Marsfan/Bus-Loop-Display/Board-electronics/LED Board/LED Board.kicad_pcb

## KiCad design Board-electronics/LED Board/LED Board.kicad_pcb (2017-06-11)

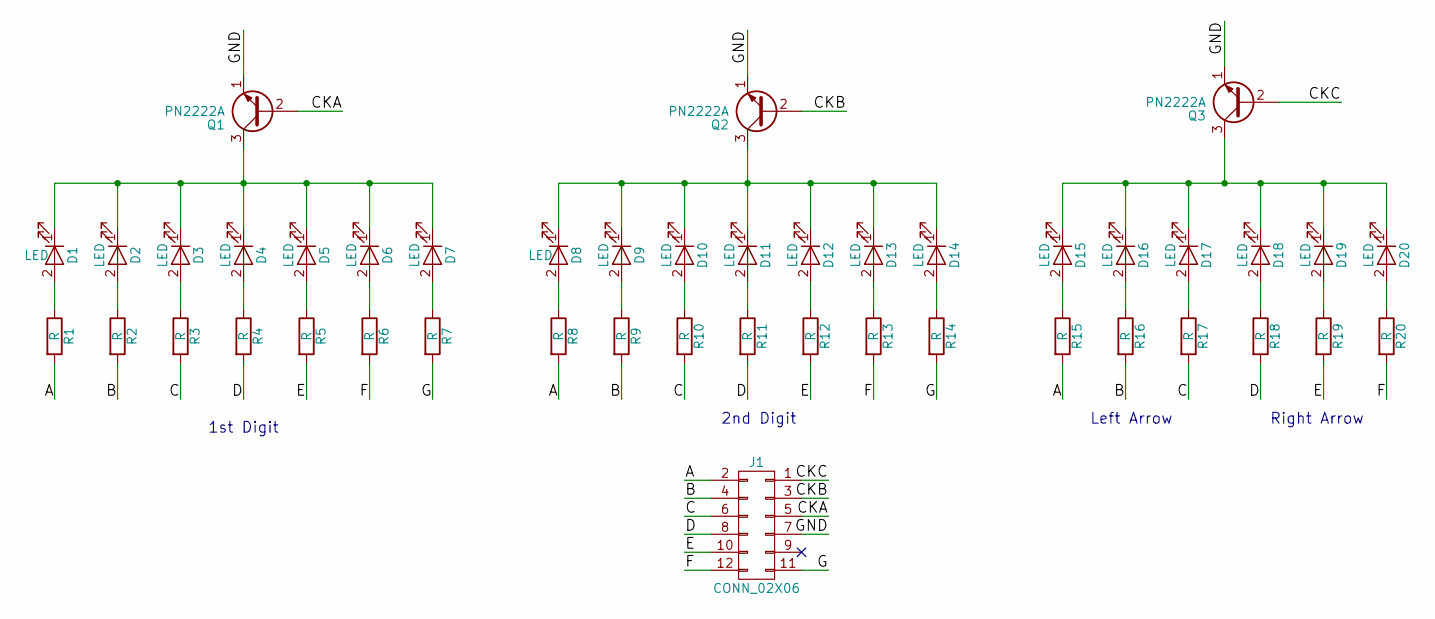
[picture p2: schematic LED Board.sch, LED Display Board]

Parts:
D1, D2, D3, D4, D5, D6, D7, D8, D9, D10, D11, D12, D13, D14, D15, D16, D17, D18, D19, D20: LED; LED_D5.0mm
J1: CONN_02X06; Picofit-12
Q1, Q2, Q3: PN2222A; TO-92_Molded_Wide_Oval
R1, R2, R3, R4, R5, R6, R7, R8, R9, R10, R11, R12, R13, R14, R15, R16, R17, R18, R19, R20: R; R_Axial_DIN0207_L6.3mm_D2.5mm_P10.16mm_Horizontal

Connections:
/A: J1.2, R1.2, R8.2, R15.2
/B: J1.4, R2.2, R9.2, R16.2
/C: J1.6, R3.2, R10.2, R17.2
/CKA: J1.5, Q1.2 (B)
/CKB: J1.3, Q2.2 (B)
/CKC: J1.1, Q3.2 (B)
/D: J1.8, R4.2, R11.2, R18.2
/E: J1.10, R5.2, R12.2, R19.2
/F: J1.12, R6.2, R13.2, R20.2
/G: J1.11, R7.2, R14.2
/GND: J1.7, Q1.1 (E), Q2.1 (E), Q3.1 (E)
unnamed: D1.1 (K), D2.1 (K), D3.1 (K), D4.1 (K), D5.1 (K), D6.1 (K), D7.1 (K), Q1.3 (C)
unnamed: D1.2 (A), R1.1
unnamed: D2.2 (A), R2.1
unnamed: D3.2 (A), R3.1
unnamed: D4.2 (A), R4.1
unnamed: D5.2 (A), R5.1
unnamed: D6.2 (A), R6.1
unnamed: D7.2 (A), R7.1
unnamed: D8.2 (A), R8.1
unnamed: D9.2 (A), R9.1
unnamed: D8.1 (K), D9.1 (K), D10.1 (K), D11.1 (K), D12.1 (K), D13.1 (K), D14.1 (K), Q2.3 (C)
unnamed: D10.2 (A), R10.1
unnamed: D11.2 (A), R11.1
unnamed: D12.2 (A), R12.1
unnamed: D13.2 (A), R13.1
unnamed: D14.2 (A), R14.1
unnamed: D15.1 (K), D16.1 (K), D17.1 (K), D18.1 (K), D19.1 (K), D20.1 (K), Q3.3 (C)
unnamed: D15.2 (A), R15.1
unnamed: D16.2 (A), R16.1
unnamed: D17.2 (A), R17.1
unnamed: D18.2 (A), R18.1
unnamed: D19.2 (A), R19.1
unnamed: D20.2 (A), R20.1

Notes on the sheet:
1st Digit
2nd Digit
Left Arrow
Right Arrow

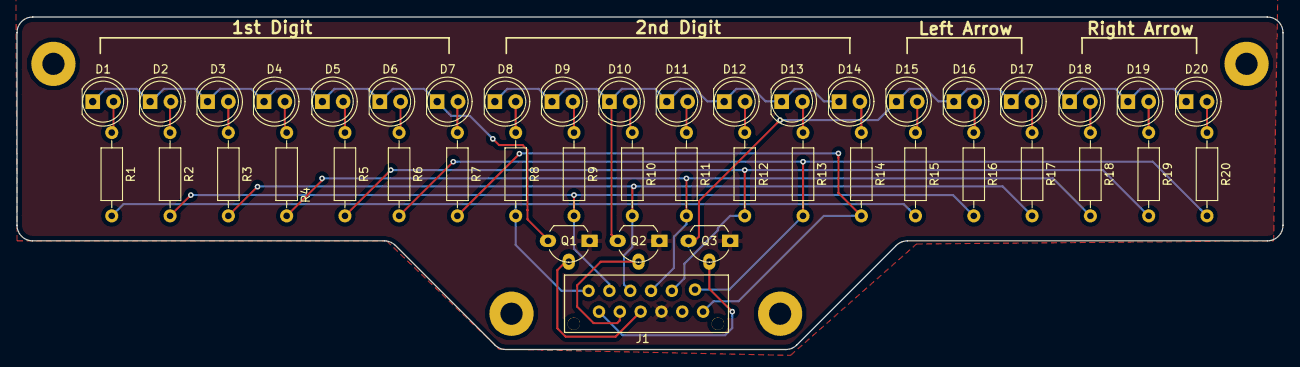
[picture p3: board LED Board.kicad_pcb from above]

Board: 2 copper layers, 154.4 x 40.6 mm, 44 parts (0 on the bottom side), 34 nets.
