Marsfan/Bus-Loop-Display/Board-electronics/Control Board no expansion header/Board Electronics.kicad_pcb

## KiCad design Board-electronics/Control Board no expansion header/Board Electronics.kicad_pcb (2017-05-10)

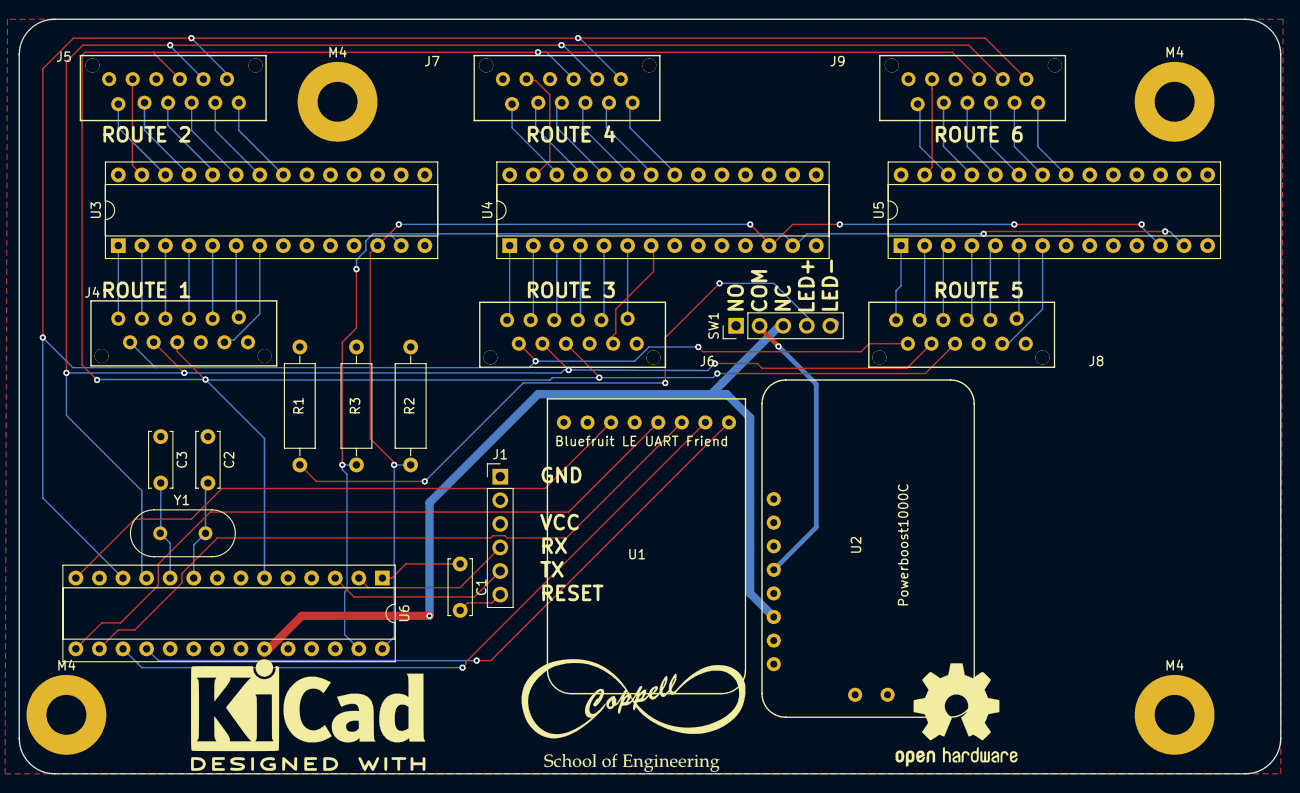
[picture p4: board Board-electronics/Control Board no expansion header/Board Electronics… from above]

Board: 2 copper layers, 135.9 x 81.3 mm, 25 parts (0 on the bottom side), 63 nets.

Parts:
C1: C.1uF; C_Disc_D6.0mm_W2.5mm_P5.00mm
C2, C3: C20p; C_Disc_D6.0mm_W2.5mm_P5.00mm
J1: CONN_01X06; Pin_Header_Straight_1x06_Pitch2.54mm
J4, J5, J6, J7, J8, J9: CONN_02X06; Picofit-12
M4, M4#2, M4#3, M4#4: MountingHole_4.3mm_M4_Pad
R1: R220; R_Axial_DIN0309_L9.0mm_D3.2mm_P12.70mm_Horizontal
R2, R3: R4K7; R_Axial_DIN0309_L9.0mm_D3.2mm_P12.70mm_Horizontal
SW1: SW_SPDT_LED; Pin_Header_Straight_1x05_Pitch2.54mm
U1: Adafruit_Bluefruit_LE_UART_Friend; Blueferuit_LE_UART
U2: Powerboost1000C; Powerboost1000c
U3, U4, U5: MCP23017; DIP-28_W7.62mm_Socket
U6: ATMEGA328P-PU; DIP-28_W7.62mm_Socket
Y1: Crystal; Crystal_HC49-U_Vertical

Connections:
/CKA: J4.5, J5.5, J6.5, J7.5, J8.5, J9.5, U6.6
/CKB: J4.3, J5.3, J6.3, J7.3, J8.3, J9.3, U6.11
/CKC: J4.1, J5.1, J6.1, J7.1, J8.1, J9.1, U6.12
/CTS: U1.2, U6.17
/GND: C2.1, C3.1, J1.1, J4.7, J5.7, J6.7, J7.7, J8.7, J9.7, SW1.1, SW1.5, U1.7, U2.7, U3.10, U3.15, U3.16, U3.17, U4.10, U4.16, U4.17, U5.10, U5.16, U5.17, U6.8, U6.22
/MOD: U1.1, U6.18
/RST: C1.2, J1.6
/RTS: U1.6, U6.14
/RX: J1.4, U6.2
/RXI: U1.4, U6.15
/SCL: R2.1, U3.12, U4.12, U5.12, U6.28
/SDA: R3.1, U3.13, U4.13, U5.13, U6.27
/TX: J1.5, U6.3
/TXO: U1.3, U6.16
/VCC: J1.3, R1.2, R2.2, R3.2, U1.5, U2.8, U3.9, U3.18, U4.9, U4.15, U4.18, U5.9, U5.15, U5.18, U6.7, U6.20
/controller.sch/A0: SW1.3, U2.6, U6.23
/controller.sch/RESET: C1.1, U6.1
unnamed: C2.2, U6.9, Y1.1
unnamed: C3.2, U6.10, Y1.2
unnamed: J4.2, U3.1
unnamed: J4.4, U3.2
unnamed: J4.6, U3.3
unnamed: J4.8, U3.4
unnamed: J4.9, U3.7
unnamed: J4.10, U3.5
unnamed: J4.12, U3.6
unnamed: J5.2, U3.21
unnamed: J5.4, U3.22
unnamed: J5.6, U3.23
unnamed: J5.8, U3.24
unnamed: J5.9, U3.27
unnamed: J5.10, U3.25
unnamed: J5.12, U3.26
unnamed: J6.2, U4.1
unnamed: J6.4, U4.2
unnamed: J6.6, U4.3
unnamed: J6.8, U4.4
unnamed: J6.9, U4.7
unnamed: J6.10, U4.5
unnamed: J6.12, U4.6
unnamed: J7.2, U4.21
unnamed: J7.4, U4.22
unnamed: J7.6, U4.23
unnamed: J7.8, U4.24
unnamed: J7.9, U4.27
unnamed: J7.10, U4.25
unnamed: J7.12, U4.26
unnamed: J8.2, U5.1
unnamed: J8.4, U5.2
unnamed: J8.6, U5.3
unnamed: J8.8, U5.4
unnamed: J8.9, U5.7
unnamed: J8.10, U5.5
unnamed: J8.12, U5.6
unnamed: J9.2, U5.21
unnamed: J9.4, U5.22
unnamed: J9.6, U5.23
unnamed: J9.8, U5.24
unnamed: J9.9, U5.27
unnamed: J9.10, U5.25
unnamed: J9.12, U5.26
unnamed: R1.1, SW1.4
unnamed: SW1.2, U2.4
