Marsfan/Bus-Loop-Display/Board-electronics/Control Board/Board Electronics.kicad_pcb

## KiCad design Board-electronics/Control Board/Board Electronics.kicad_pcb (2018-11-01)

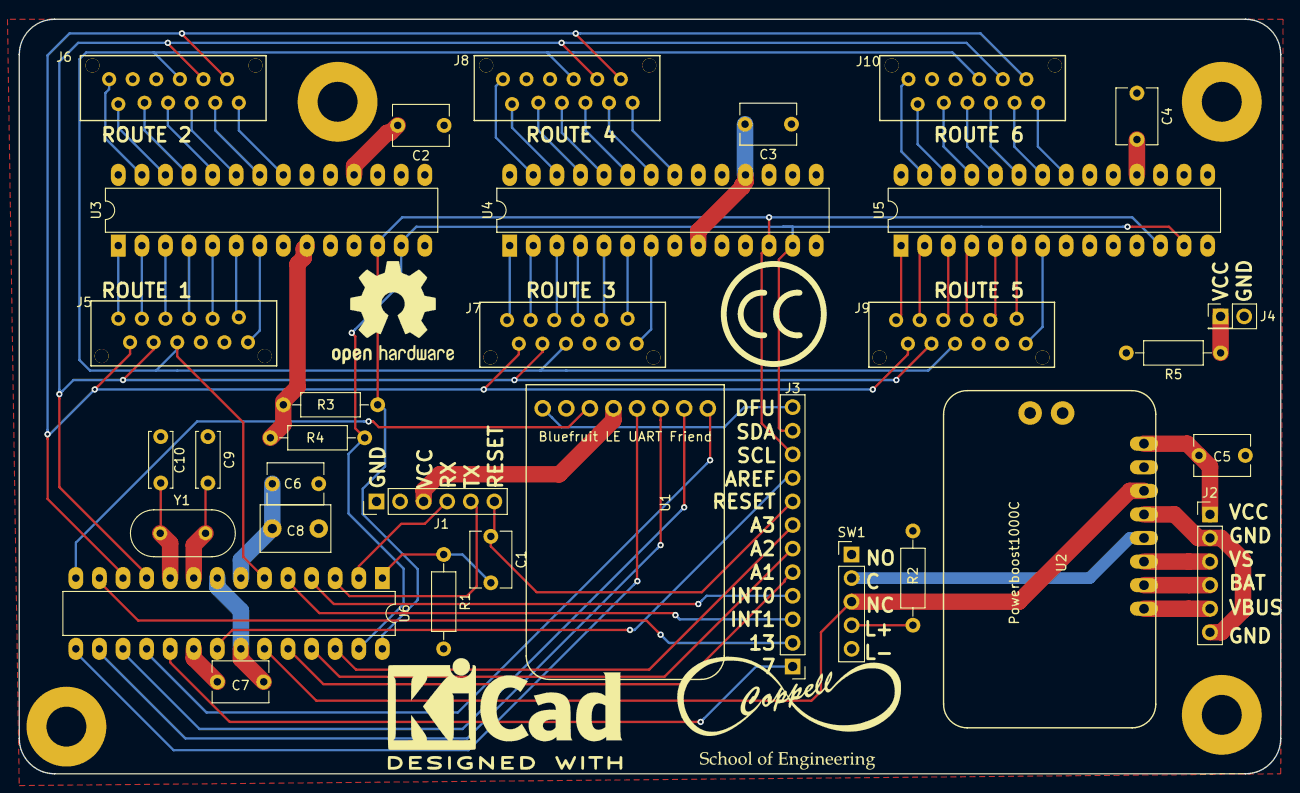
[picture p5: board Board-electronics/Control Board/Board Electronics.kicad_pcb from above]

Board: 2 copper layers, 135.9 x 81.3 mm, 37 parts (0 on the bottom side), 77 nets.

Parts:
C1: C.1uF; C_Disc_D6.0mm_W4.4mm_P5.00mm
C2, C3, C4, C6, C7: C.1u; C_Disc_D6.0mm_W4.4mm_P5.00mm
C5: C10u; C_Disc_D6.0mm_W4.4mm_P5.00mm
C8: C4.7u; C_Disc_D7.5mm_W5.0mm_P5.00mm
C9, C10: C20p; C_Disc_D6.0mm_W2.5mm_P5.00mm
J1, J2: CONN_01X06; Pin_Header_Straight_1x06_Pitch2.54mm
J3: CONN_01X12; Pin_Header_Straight_1x12_Pitch2.54mm
J4: CONN_02X01; Pin_Header_Straight_2x01_Pitch2.54mm
J5, J6, J7, J8, J9, J10: CONN_02X06; Picofit-12
M4, M4#2, M4#3, M4#4: MountingHole_4.3mm_M4_Pad
R1: R4.7K; R_Axial_DIN0207_L6.3mm_D2.5mm_P10.16mm_Horizontal
R2: R220; R_Axial_DIN0207_L6.3mm_D2.5mm_P10.16mm_Horizontal
R3, R4: R4K7; R_Axial_DIN0207_L6.3mm_D2.5mm_P10.16mm_Horizontal
R5: R; R_Axial_DIN0207_L6.3mm_D2.5mm_P10.16mm_Horizontal
SW1: SW_SPDT_LED; Pin_Header_Straight_1x05_Pitch2.54mm
U1: Adafruit_Bluefruit_LE_UART_Friend; Blueferuit_LE_UART
U2: Powerboost1000C; Powerboost1000c
U3, U4, U5: MCP23017; DIP-28_W7.62mm_LongPads
U6: ATMEGA328P-PU; DIP-28_W7.62mm_LongPads
Y1: Crystal; Crystal_HC49-U_Vertical

Connections:
/7: J3.2, U6.13
/13: J3.1, U6.19
/A0: SW1.3, U2.6, U6.23
/A1: J3.5, U6.24
/A2: J3.6, U6.25
/A3: J3.7, U6.26
/AREF: J3.9, U6.21
/BAT: J2.4, U2.2
/BLE_DFU: J3.12, U1.8
/CKA: J5.5, J6.5, J7.5, J8.5, J9.5, J10.5, U6.6
/CKB: J5.3, J6.3, J7.3, J8.3, J9.3, J10.3, U6.11
/CKC: J5.1, J6.1, J7.1, J8.1, J9.1, J10.1, U6.12
/CTS: U1.2, U6.17
/G: J2.2, J2.6, U2.5
/GND: C2.1, C3.1, C4.1, C5.2, C6.1, C7.2, C8.1, C9.1, C10.1, J1.1, J4.2, J5.7, J6.7, J7.7, J8.7, J9.7, J10.7, SW1.1, SW1.5, U1.7, U2.7, U3.10, U3.15, U3.16, U3.17, U4.10, U4.16, U4.17, U5.10, U5.17, U6.8, U6.22
/INT0: J3.4, U6.4
/INT1: J3.3, U6.5
/MOD: U1.1, U6.18
/RST: C1.1, J1.6, J3.8
/RTS: U1.6, U6.14
/RX: J1.4, U6.2
/RXI: U1.4, U6.15
/SCL: J3.10, R3.1, U3.12, U4.12, U5.12, U6.28
/SDA: J3.11, R4.1, U3.13, U4.13, U5.13, U6.27
/SW1_COM: SW1.2, U2.4
/TX: J1.5, U6.3
/TXO: U1.3, U6.16
/VBUS: J2.5, U2.1
/VCC: C2.2, C3.2, C4.2, C5.1, C6.2, C7.1, C8.2, J1.3, J2.1, R1.2, R2.2, R3.2, R4.2, R5.2, U1.5, U2.8, U3.9, U3.18, U4.9, U4.15, U4.18, U5.9, U5.15, U5.16, U5.18, U6.7, U6.20
/VS: J2.3, U2.3
/controller.sch/RESET: C1.2, R1.1, U6.1
unnamed: C9.2, U6.9, Y1.1
unnamed: C10.2, U6.10, Y1.2
unnamed: J4.1, R5.1
unnamed: J5.2, U3.1
unnamed: J5.4, U3.2
unnamed: J5.6, U3.3
unnamed: J5.8, U3.4
unnamed: J5.10, U3.5
unnamed: J5.11, U3.7
unnamed: J5.12, U3.6
unnamed: J6.2, U3.21
unnamed: J6.4, U3.22
unnamed: J6.6, U3.23
unnamed: J6.8, U3.24
unnamed: J6.10, U3.25
unnamed: J6.11, U3.27
unnamed: J6.12, U3.26
unnamed: J7.2, U4.1
unnamed: J7.4, U4.2
unnamed: J7.6, U4.3
unnamed: J7.8, U4.4
unnamed: J7.10, U4.5
unnamed: J7.11, U4.7
unnamed: J7.12, U4.6
unnamed: J8.2, U4.21
unnamed: J8.4, U4.22
unnamed: J8.6, U4.23
unnamed: J8.8, U4.24
unnamed: J8.10, U4.25
unnamed: J8.11, U4.27
unnamed: J8.12, U4.26
unnamed: J9.2, U5.1
unnamed: J9.4, U5.2
unnamed: J9.6, U5.3
unnamed: J9.8, U5.4
unnamed: J9.10, U5.5
unnamed: J9.11, U5.7
unnamed: J9.12, U5.6
unnamed: J10.2, U5.21
unnamed: J10.4, U5.22
unnamed: J10.6, U5.23
unnamed: J10.8, U5.24
unnamed: J10.10, U5.25
unnamed: J10.11, U5.27
unnamed: J10.12, U5.26
unnamed: R2.1, SW1.4
