Marsfan/Bus-Loop-Display/(commit log)

2017-03-06 add arduino and electronic schematics
    [Board Electronics.kicad_pcb, Board Electronics.sch, BusLoopId.sch, Controller.sch]
2017-03-09 Finished Single Board PCB Design
    [Board Electronics.kicad_pcb, Board Electronics.sch, BusLoopId.sch, Controller.sch]
2017-03-09 Finished Arduino Code
2017-03-09 added copper pours
    [Board Electronics.kicad_pcb]
2017-03-24 update Kicad files to have new schematic design
    This new schematic design is nested under a new folder called
    alternative board electronics. It breaks apart the control circuitry and
    the led attachment points to save PCB space (and this cost).
    This may become the default schematics in a future revision, and the
    all-in-one board will become the alternative.
    [Board Electronics-B.Cu.gbr, Board Electronics-B.Mask.gbr, Board Electronics-B.SilkS.gbr, Board Electronics-Edge.Cuts.gbr, Board Electronics-F.Cu.gbr, Board Electronics-F.Mask.gbr, Board Electronics-F.SilkS.gbr, Board Electronics-Margin.gbr]
2017-03-24 added low battery warning, changed arrows hex values
2017-04-13 Button Positions now stay the same based on platform/rotation
2017-05-10 FIxed an error with B registers not working properly
    [bus_display.ino]
2017-05-10 rework a lot of things to make it work better
    [Board Electronics - Copy.kicad_pcb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]
2017-05-10 add copper pour
    [Board Electronics.kicad_pcb]
2017-05-12 more tweaking for perfection
    [Board Electronics - Copy.kicad_pcb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]
2017-06-11 just some more tweaks
    [Board Electronics - Copy.kicad_pcb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]
2018-07-01 Some Tweaks I never pushed
    [Board Electronics.kicad_pcb, Board Electronics.sch, Controller.sch]
2018-11-01 Upgraded control board schematic to KiCad V5
    [Board Electronics-2018-10-31-17-22-35.sch, Board Electronics.kicad_pcb, Controller-2018-10-31-17-22-35.sch]
